Drakonchyk/lab-can/can_nucleo_С/can_nucleo_new/Core/Src/main.c

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
/* Includes ------------------------------------------------------------------*/
#include "main.h"

/* USER CODE BEGIN Includes */
#include <string.h>
#include <stdbool.h>

#define CMD_TOKEN 0x42   // спільний секретний токен для CMD
#define CMD_VER   0x01
/* USER CODE END Includes */

CAN_HandleTypeDef hcan1;

UART_HandleTypeDef huart2;

/* USER CODE BEGIN PV */
volatile uint8_t g_rx_flag = 0; // 0 = нічого, 1 = CMD (FIFO0), 2 = HB (FIFO1)

// Прапорці для відкладеного ACK
volatile uint8_t g_ack_pending = 0;
volatile uint8_t g_ack_cmd_id = 0;
volatile uint8_t g_ack_seq    = 0;
volatile uint8_t g_ack_result = 0;

CAN_TxHeaderTypeDef C_TxHeader;
CAN_RxHeaderTypeDef C_RxHeader;
uint8_t C_TxData[8];
uint8_t C_RxData[8];
/* USER CODE END PV */

void SystemClock_Config(void);
static void MX_GPIO_Init(void);
static void MX_USART2_UART_Init(void);
static void MX_CAN1_Init(void);
/* USER CODE BEGIN PFP */
static void CAN_ConfigFilters_NodeC(void);
static void C_Send_ACK(uint8_t cmd_id, uint8_t seq, uint8_t result);
uint8_t crc8(const uint8_t *data, uint8_t len);
/* USER CODE END PFP */

/* USER CODE BEGIN 0 */

// CRC8 для CmdID|Arg0|Arg1|Arg2|Token|Seq|Ver
uint8_t crc8(const uint8_t *data, uint8_t len)
{
    uint8_t crc = 0x00;
    const uint8_t poly = 0x07; // x^8 + x^2 + x + 1

    for (uint8_t i = 0; i < len; i++)
    {
        crc ^= data[i];
        for (uint8_t b = 0; b < 8; b++)
        {
            if (crc & 0x80)
                crc = (crc << 1) ^ poly;
            else
                crc <<= 1;
        }
    }
    return crc;
}

// Налаштування фільтрів: 0x040 → FIFO0, 0x081/0x082 → FIFO1
static void CAN_ConfigFilters_NodeC(void)
{
    CAN_FilterTypeDef filter = {0};

    // Bank 0: точний збіг 0x040 (CMD) → FIFO0
    filter.FilterActivation     = CAN_FILTER_ENABLE;
    filter.FilterBank           = 0;
    filter.FilterFIFOAssignment = CAN_RX_FIFO0;
    filter.FilterMode           = CAN_FILTERMODE_IDMASK;
    filter.FilterScale          = CAN_FILTERSCALE_32BIT;
    filter.FilterIdHigh         = (0x040 << 5);
    filter.FilterIdLow          = 0x0000;
    filter.FilterMaskIdHigh     = (0x7FF << 5); // всі 11 біт важливі
    filter.FilterMaskIdLow      = 0x0000;
    filter.SlaveStartFilterBank = 14;
    HAL_CAN_ConfigFilter(&hcan1, &filter);

    // Bank 1: точний збіг 0x081 (HB A) → FIFO1
    filter.FilterBank           = 1;
    filter.FilterFIFOAssignment = CAN_RX_FIFO1;
    filter.FilterIdHigh         = (0x081 << 5);
    filter.FilterIdLow          = 0x0000;
    filter.FilterMaskIdHigh     = (0x7FF << 5);
    filter.FilterMaskIdLow      = 0x0000;
    HAL_CAN_ConfigFilter(&hcan1, &filter);

    // Bank 2: точний збіг 0x082 (HB B) → FIFO1
    filter.FilterBank           = 2;
    filter.FilterFIFOAssignment = CAN_RX_FIFO1;
    filter.FilterIdHigh         = (0x082 << 5);
    filter.FilterIdLow          = 0x0000;
    filter.FilterMaskIdHigh     = (0x7FF << 5);
    filter.FilterMaskIdLow      = 0x0000;
    HAL_CAN_ConfigFilter(&hcan1, &filter);
}

// Відправка ACK/ERR (0x041)
static void C_Send_ACK(uint8_t cmd_id, uint8_t seq, uint8_t result)
{
	uint32_t txMailbox;
	uint32_t freeLevel;

    C_TxHeader.StdId = 0x041;
    C_TxHeader.ExtId = 0;
    C_TxHeader.IDE   = CAN_ID_STD;
    C_TxHeader.RTR   = CAN_RTR_DATA;
    C_TxHeader.DLC   = 8;
    C_TxHeader.TransmitGlobalTime = DISABLE;

    memset(C_TxData, 0, sizeof(C_TxData));
    C_TxData[0] = cmd_id;
    C_TxData[1] = seq;
    C_TxData[2] = result;   // 0=OK, 1=CRC fail, 2=Token fail, 3=Ver fail

    freeLevel = HAL_CAN_GetTxMailboxesFreeLevel(&hcan1);
	if (freeLevel == 0)
	{
		// ERROR: All mailboxes full. This means previous messages weren't ACKed.
		// Optional: Clear mailboxes if stuck (HAL_CAN_AbortTxRequest)
		return; // Keep g_ack_pending = 1 to retry?
	}

	if (HAL_CAN_AddTxMessage(&hcan1, &C_TxHeader, C_TxData, &txMailbox) != HAL_OK)
	{
		// Capture Error Code
		uint32_t error = HAL_CAN_GetError(&hcan1);
	}
}

/**
  * @brief Колбек для FIFO0 (Команди 0x040)
  */
void HAL_CAN_RxFifo0MsgPendingCallback(CAN_HandleTypeDef *hcan)
{
    if (hcan->Instance != CAN1) return;

    if (HAL_CAN_GetRxMessage(hcan, CAN_RX_FIFO0, &C_RxHeader, C_RxData) != HAL_OK)
        return;

    if (C_RxHeader.StdId != 0x040) return;

    uint8_t cmd_id = C_RxData[0];
    uint8_t token  = C_RxData[4];
    uint8_t seq    = C_RxData[5];
    uint8_t crc_rx = C_RxData[6];
    uint8_t ver    = C_RxData[7];

    // перерахунок CRC8 по byte[0..5] + ver (byte7)
    uint8_t tmp[7];
    memcpy(tmp, C_RxData, 6); // CmdID..Seq
    tmp[6] = ver;             // Ver
    uint8_t crc_calc = crc8(tmp, 7);

    uint8_t result;
    if (token != CMD_TOKEN) {
        result = 2;  // Token fail
    } else if (crc_rx != crc_calc) {
        result = 1;  // CRC fail
    } else if (ver != CMD_VER) {
        result = 3;  // Ver fail
    } else {
        result = 0;  // OK
    }

    // Зберігаємо ACK для відправки у main()
    g_ack_cmd_id = cmd_id;
    g_ack_seq    = seq;
    g_ack_result = result;
    g_ack_pending = 1;

    g_rx_flag = 1; // сигнал для LED-патерну (CMD)
}

/**
  * @brief Колбек для FIFO1 (Heartbeats 0x081/0x082)
  */
void HAL_CAN_RxFifo1MsgPendingCallback(CAN_HandleTypeDef *hcan)
{
    if (hcan->Instance != CAN1) return;

    if (HAL_CAN_GetRxMessage(hcan, CAN_RX_FIFO1, &C_RxHeader, C_RxData) != HAL_OK)
        return;

    if (C_RxHeader.StdId == 0x081 || C_RxHeader.StdId == 0x082)
    {
        g_rx_flag = 2; // сигнал для LED (HB)
    }
}

/* USER CODE END 0 */

int main(void)
{
  HAL_Init();
  SystemClock_Config();

  MX_GPIO_Init();
  MX_USART2_UART_Init();
  MX_CAN1_Init();

  /* USER CODE BEGIN 2 */

  // Налаштовуємо фільтри ноди C
  CAN_ConfigFilters_NodeC();

  // Стартуємо CAN
  if (HAL_CAN_Start(&hcan1) != HAL_OK)
  {
      Error_Handler();
  }

  // Вмикаємо IRQ по FIFO0/FIFO1
  HAL_CAN_ActivateNotification(&hcan1,
      CAN_IT_RX_FIFO0_MSG_PENDING |
      CAN_IT_RX_FIFO1_MSG_PENDING);

  /* USER CODE END 2 */

  while (1)
  {
    /* USER CODE BEGIN 3 */

    // 1) Якщо є ACK — спочатку його шлемо
    if (g_ack_pending)
    {
        C_Send_ACK(g_ack_cmd_id, g_ack_seq, g_ack_result);
        g_ack_pending = 0;
    }

    // 2) Потім – LED-патерни
    if (g_rx_flag == 1) // Отримали команду 0x040 (FIFO0)
    {
        // Тут залишила твій "довгий" блим-патерн :)
        for (int i = 0; i < 8; i++)
        {
            HAL_GPIO_WritePin(LD2_GPIO_Port, LD2_Pin, GPIO_PIN_SET);
            HAL_Delay(50);
            HAL_GPIO_WritePin(LD2_GPIO_Port, LD2_Pin, GPIO_PIN_RESET);
            HAL_Delay(50);
        }
        g_rx_flag = 0;
    }
    else if (g_rx_flag == 2) // Отримали HB у FIFO1 (0x081/0x082)
    {
        HAL_GPIO_TogglePin(LD2_GPIO_Port, LD2_Pin);
        g_rx_flag = 0;
    }

    // можна додати ще якийсь watchdog/diag тут, якщо треба

    /* USER CODE END 3 */
  }
}

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
