Drakonchyk/lab-can/(notices)

Notices in the files:
can_nucleo_A/can_nucleo/Core/Src/main.c:
Copyright (c) 2025 STMicroelectronics.
All rights reserved.
This software is licensed under terms that can be found in the LICENSE file
